dorsheed455k/MSI-Capstone/Images/Screenshot 2026-03-16 171824.jpg

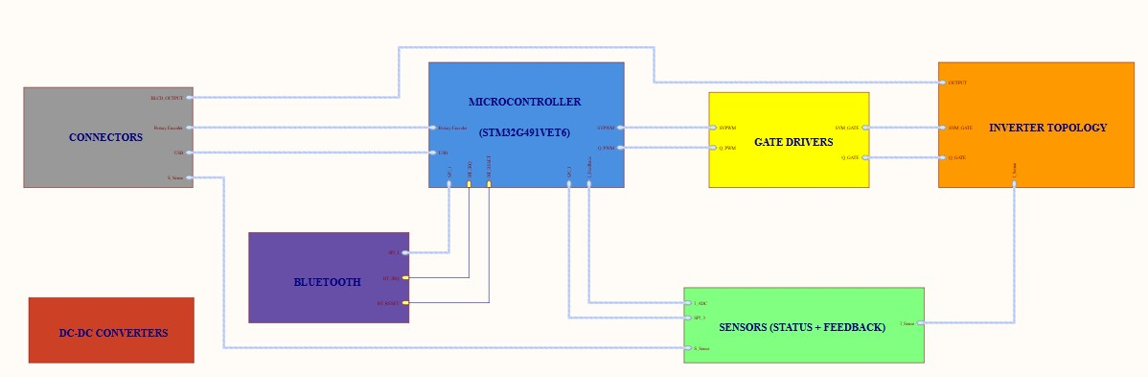
Images/Screenshot 2026-03-16 171824.jpg
