dorsheed455k/MSI-Capstone/Images/Screenshot 2026-03-30 085603.jpg

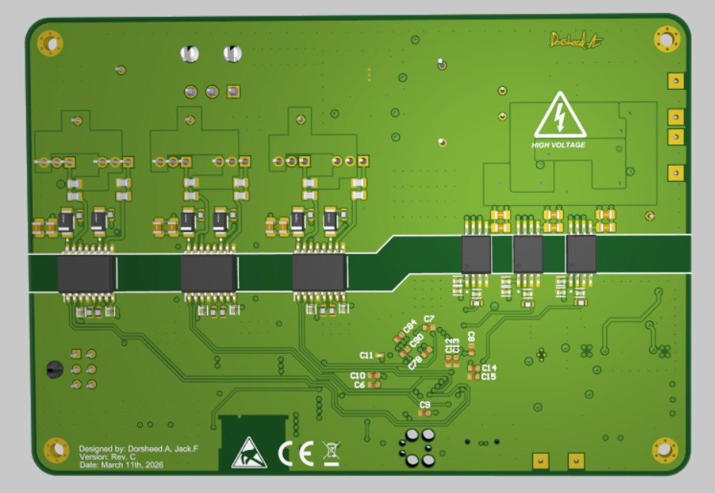
Images/Screenshot 2026-03-30 085603.jpg
