dorsheed455k/MSI-Capstone/Images/Screenshot 2026-04-18 185659.jpg

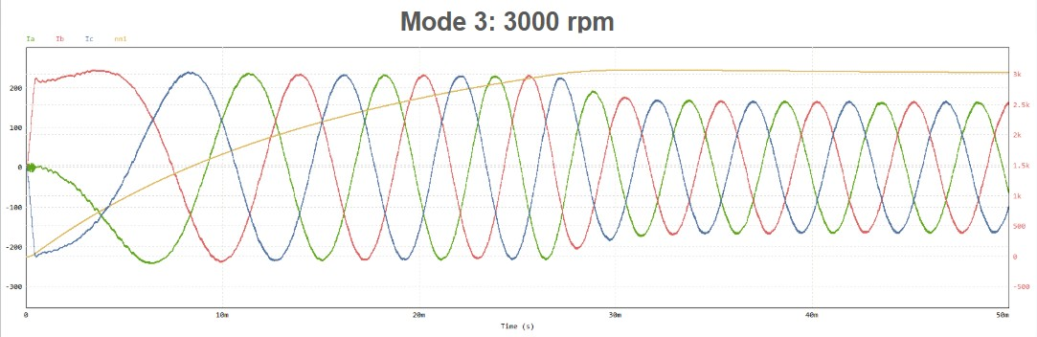
Images/Screenshot 2026-04-18 185659.jpg
