dorsheed455k/MSI-Capstone/Hardware/Schematic PDF_[No Variations] (1).pdf

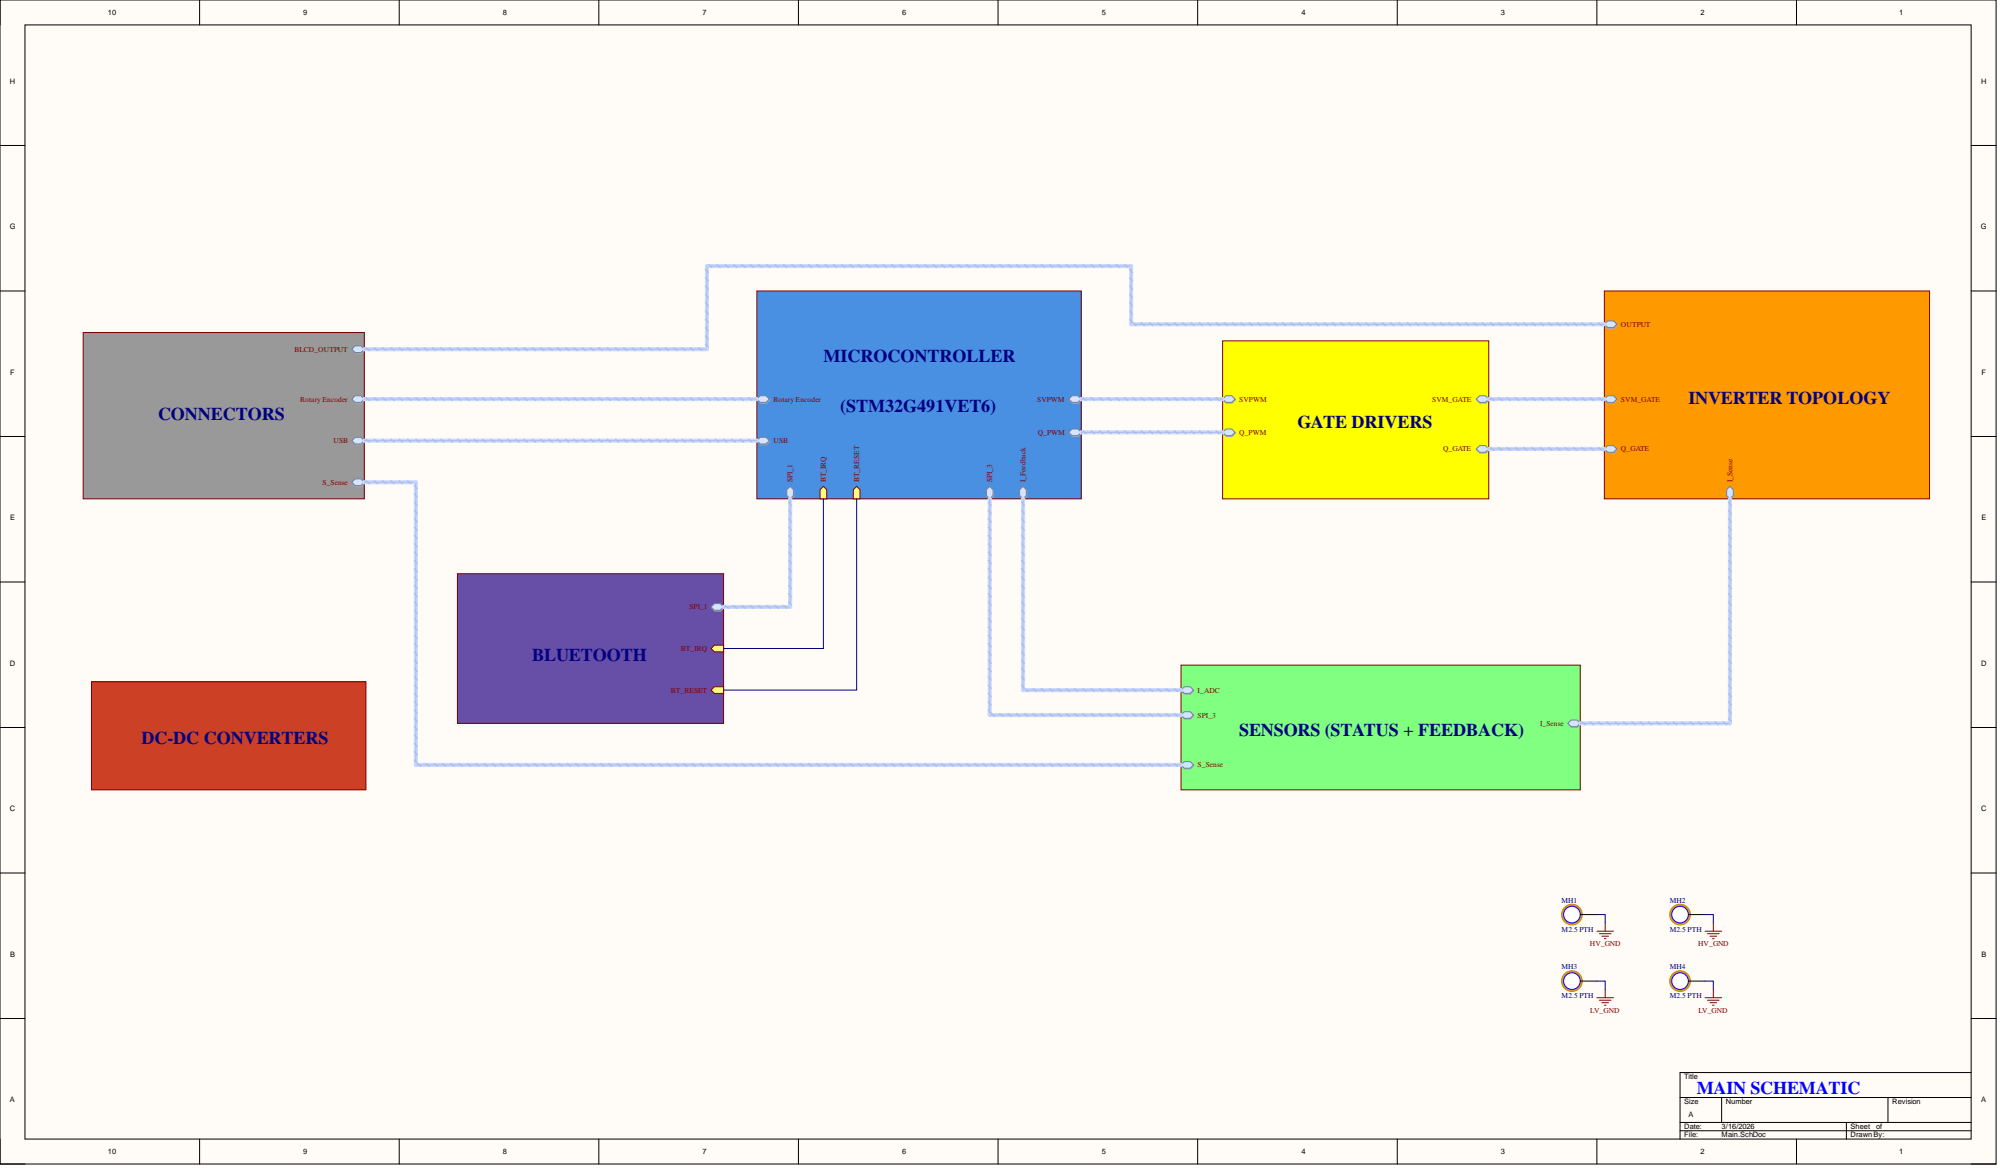
[picture p11: page 1]
Date:; Sheet of; File:; Main.SchDoc; Drawn By:; Rotary Encoder; INVERTER TOPOLOGY; MAIN SCHEMATIC; M2.5 PTH; GATE DRIVERS

SPI_3
SENSORS (STATUS + FEEDBACK)

DC-DC CONVERTERS

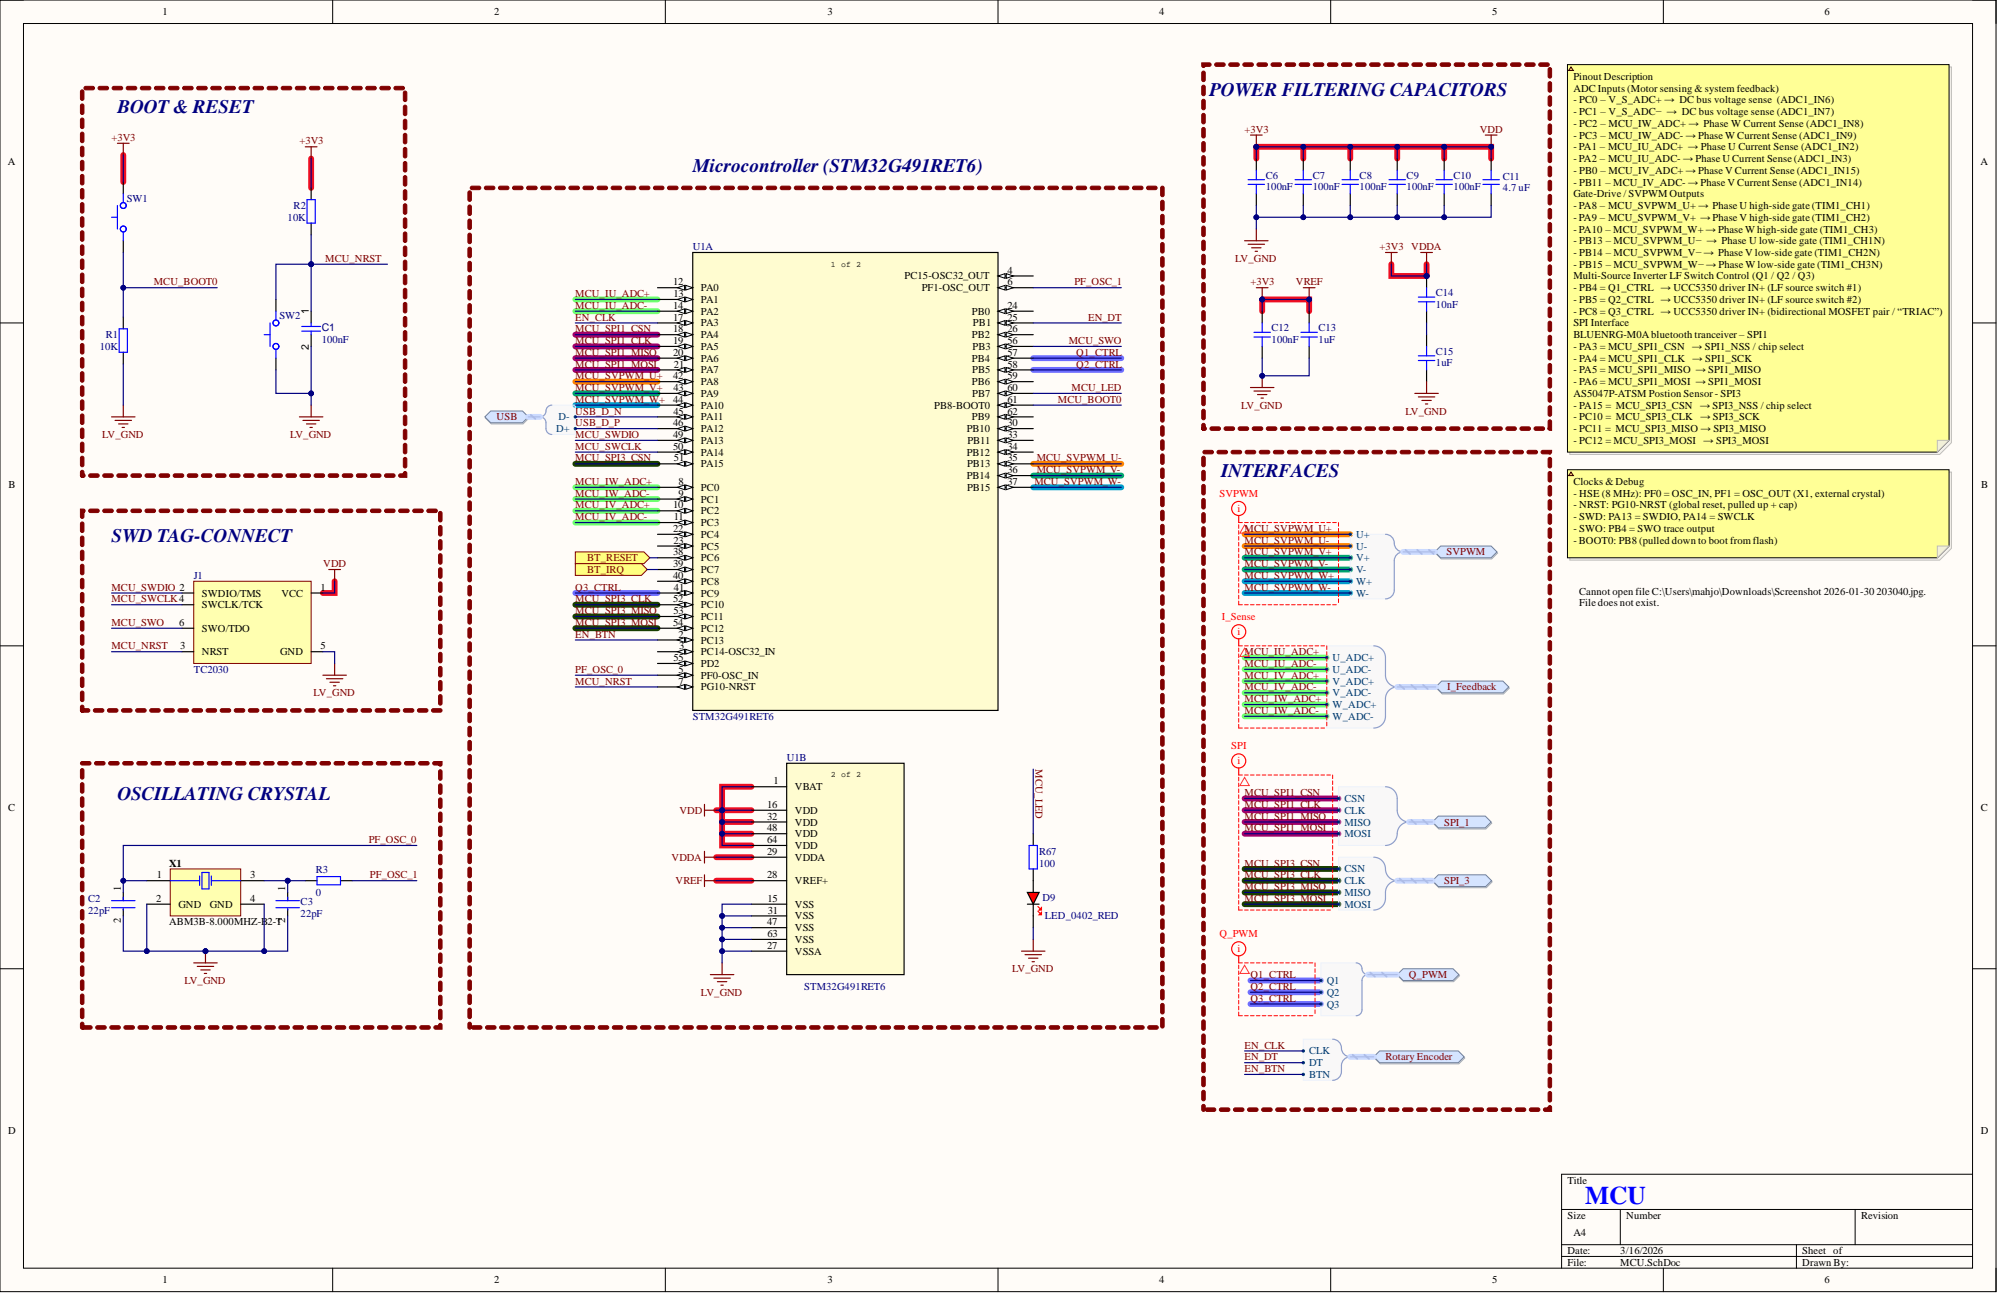
[picture p12: page 2]

1 6
3 2
4 8
6 4

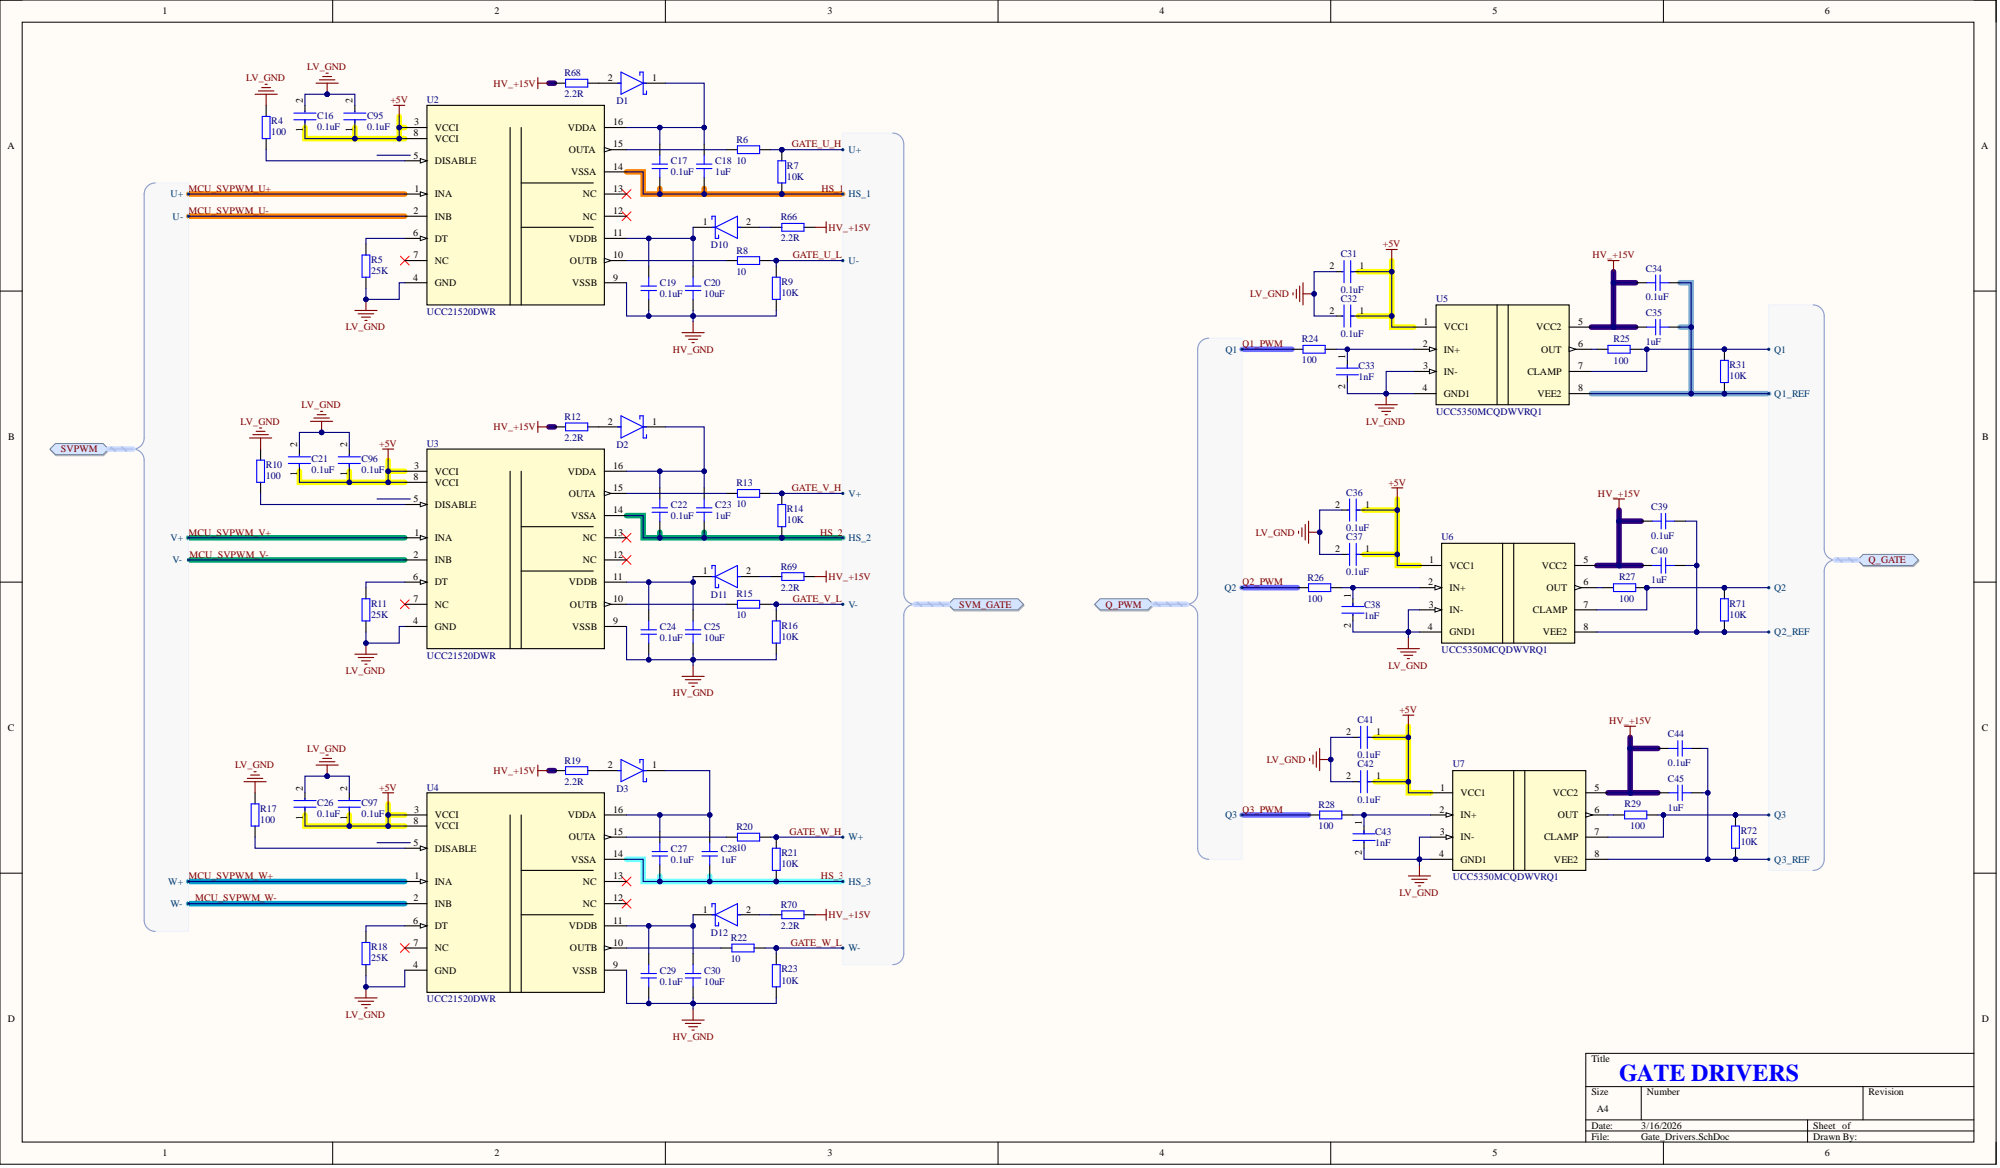
[picture p13: page 3]

C3 8 3 | | 7
1 n F | 4 | | 8

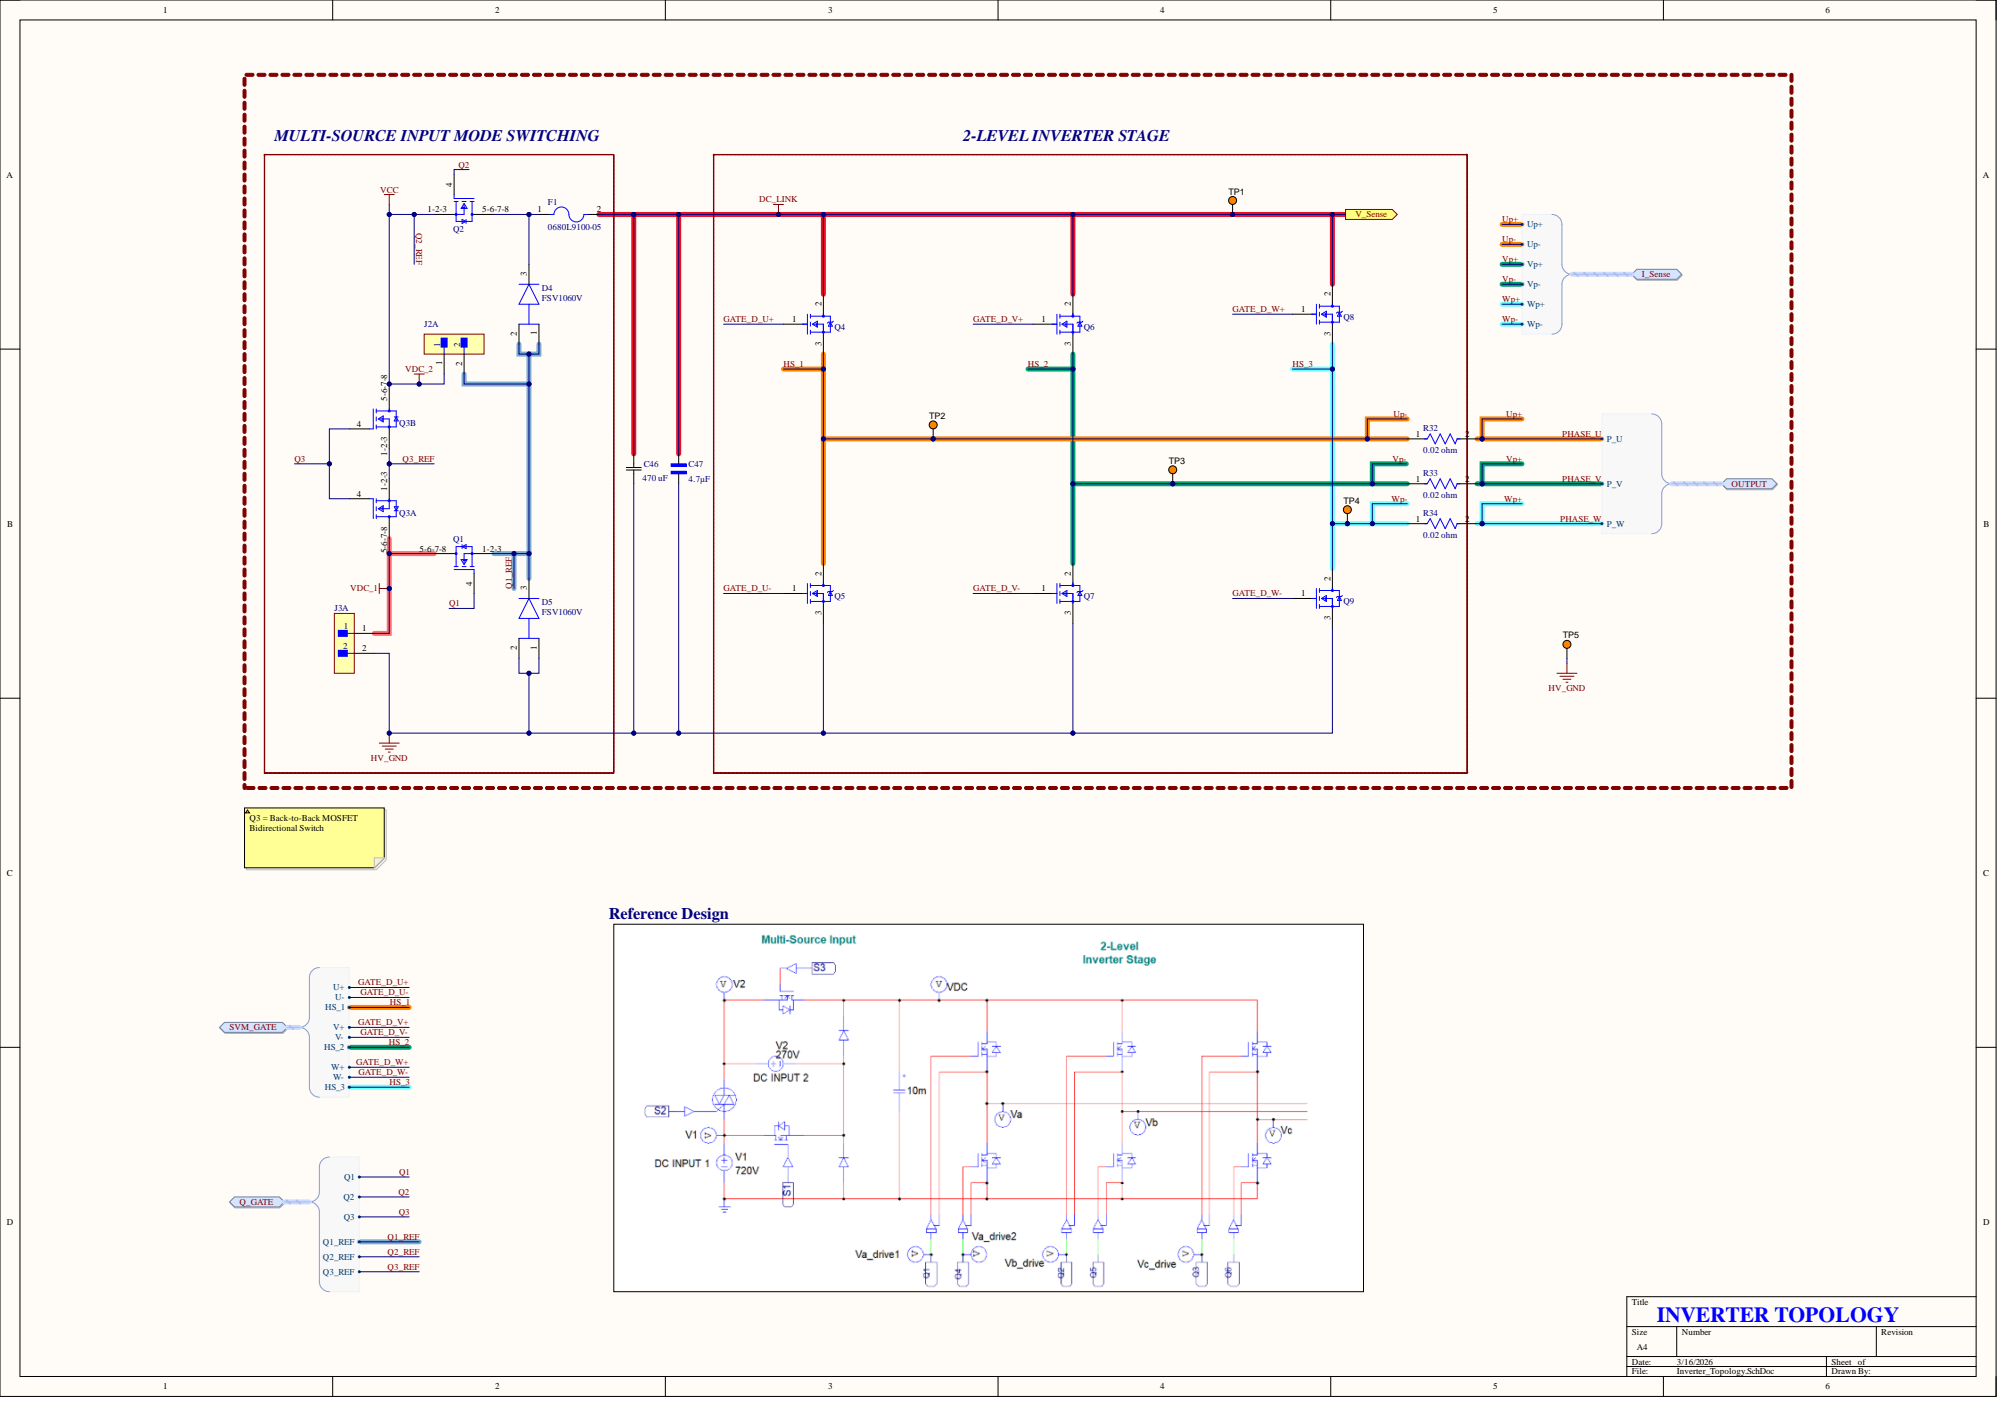
[picture p14: page 4]

MULTI-SOURCE INPUT MODE SWITCHING

Q3 = Back-to-Back MOSFET
Bidirectional Switch

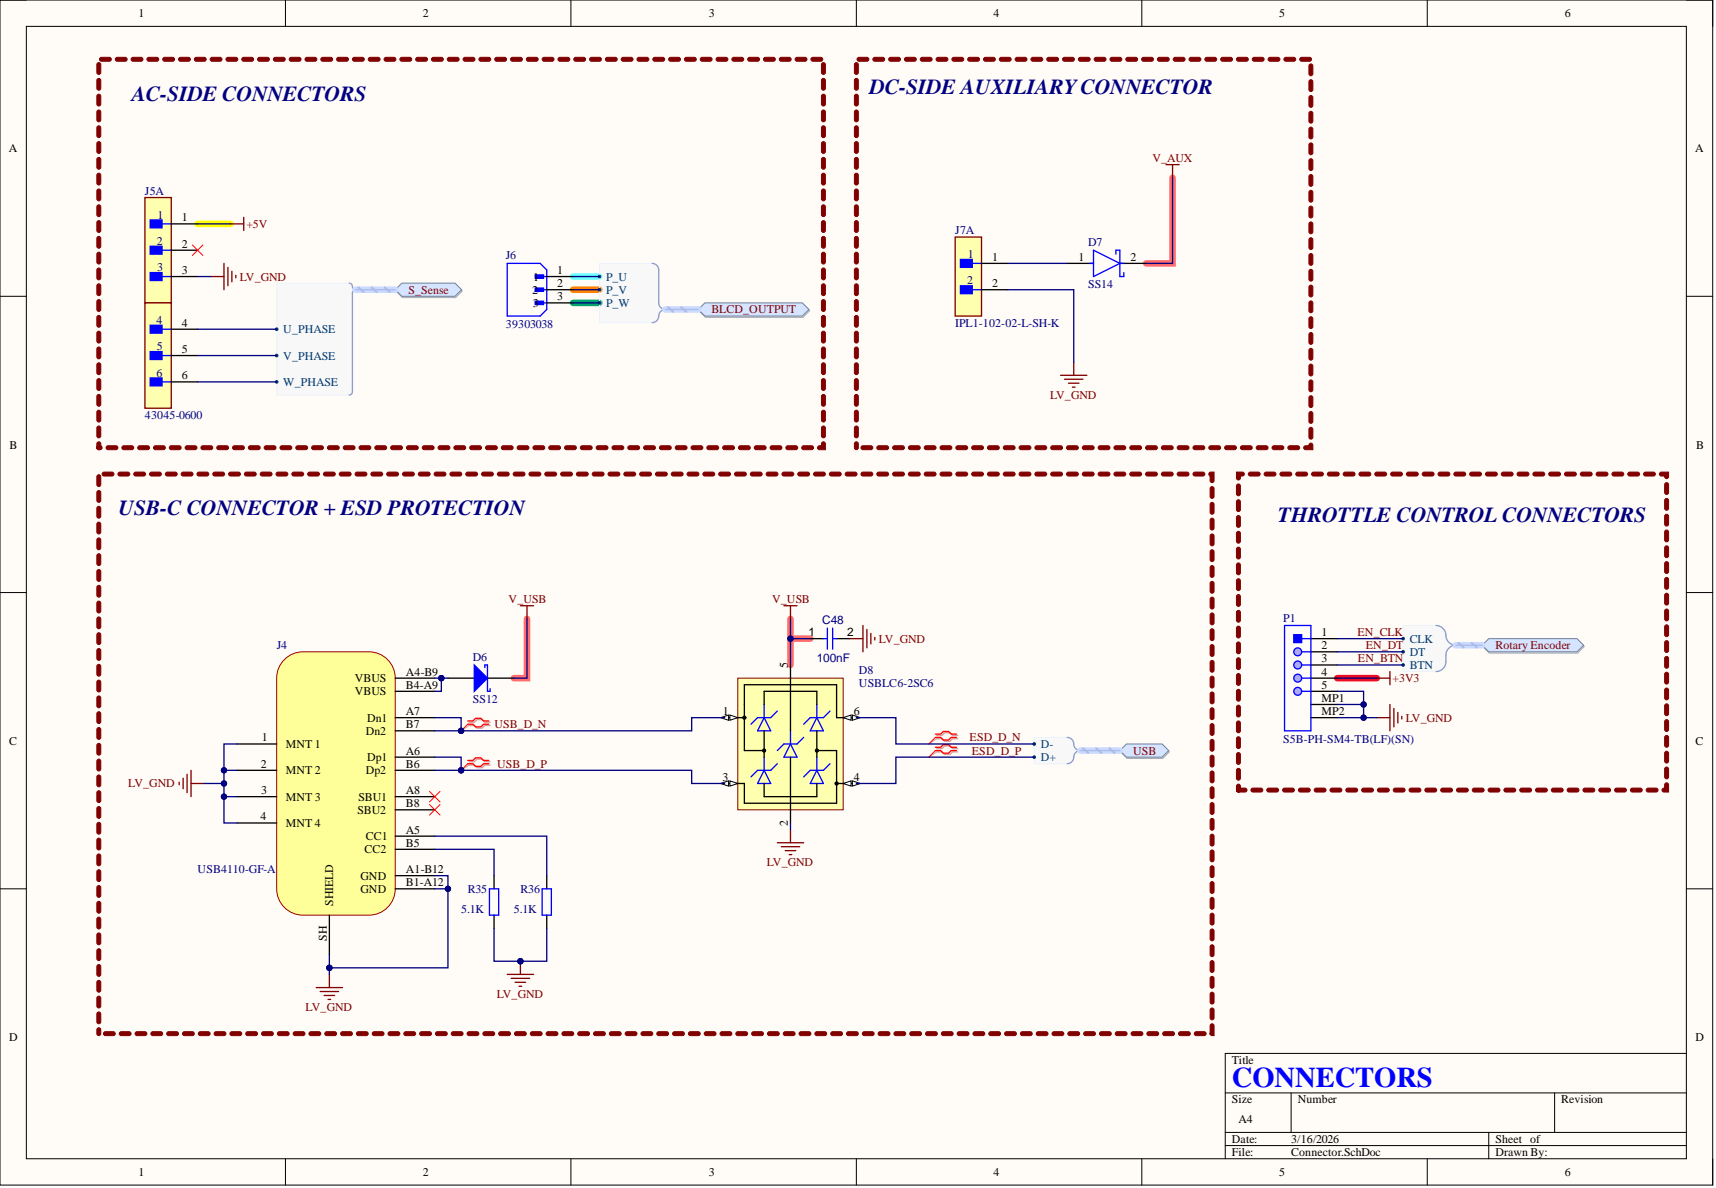
[picture p15: page 5]

USB-C CONNECTOR + ESD PROTECTION

ESD_D_N

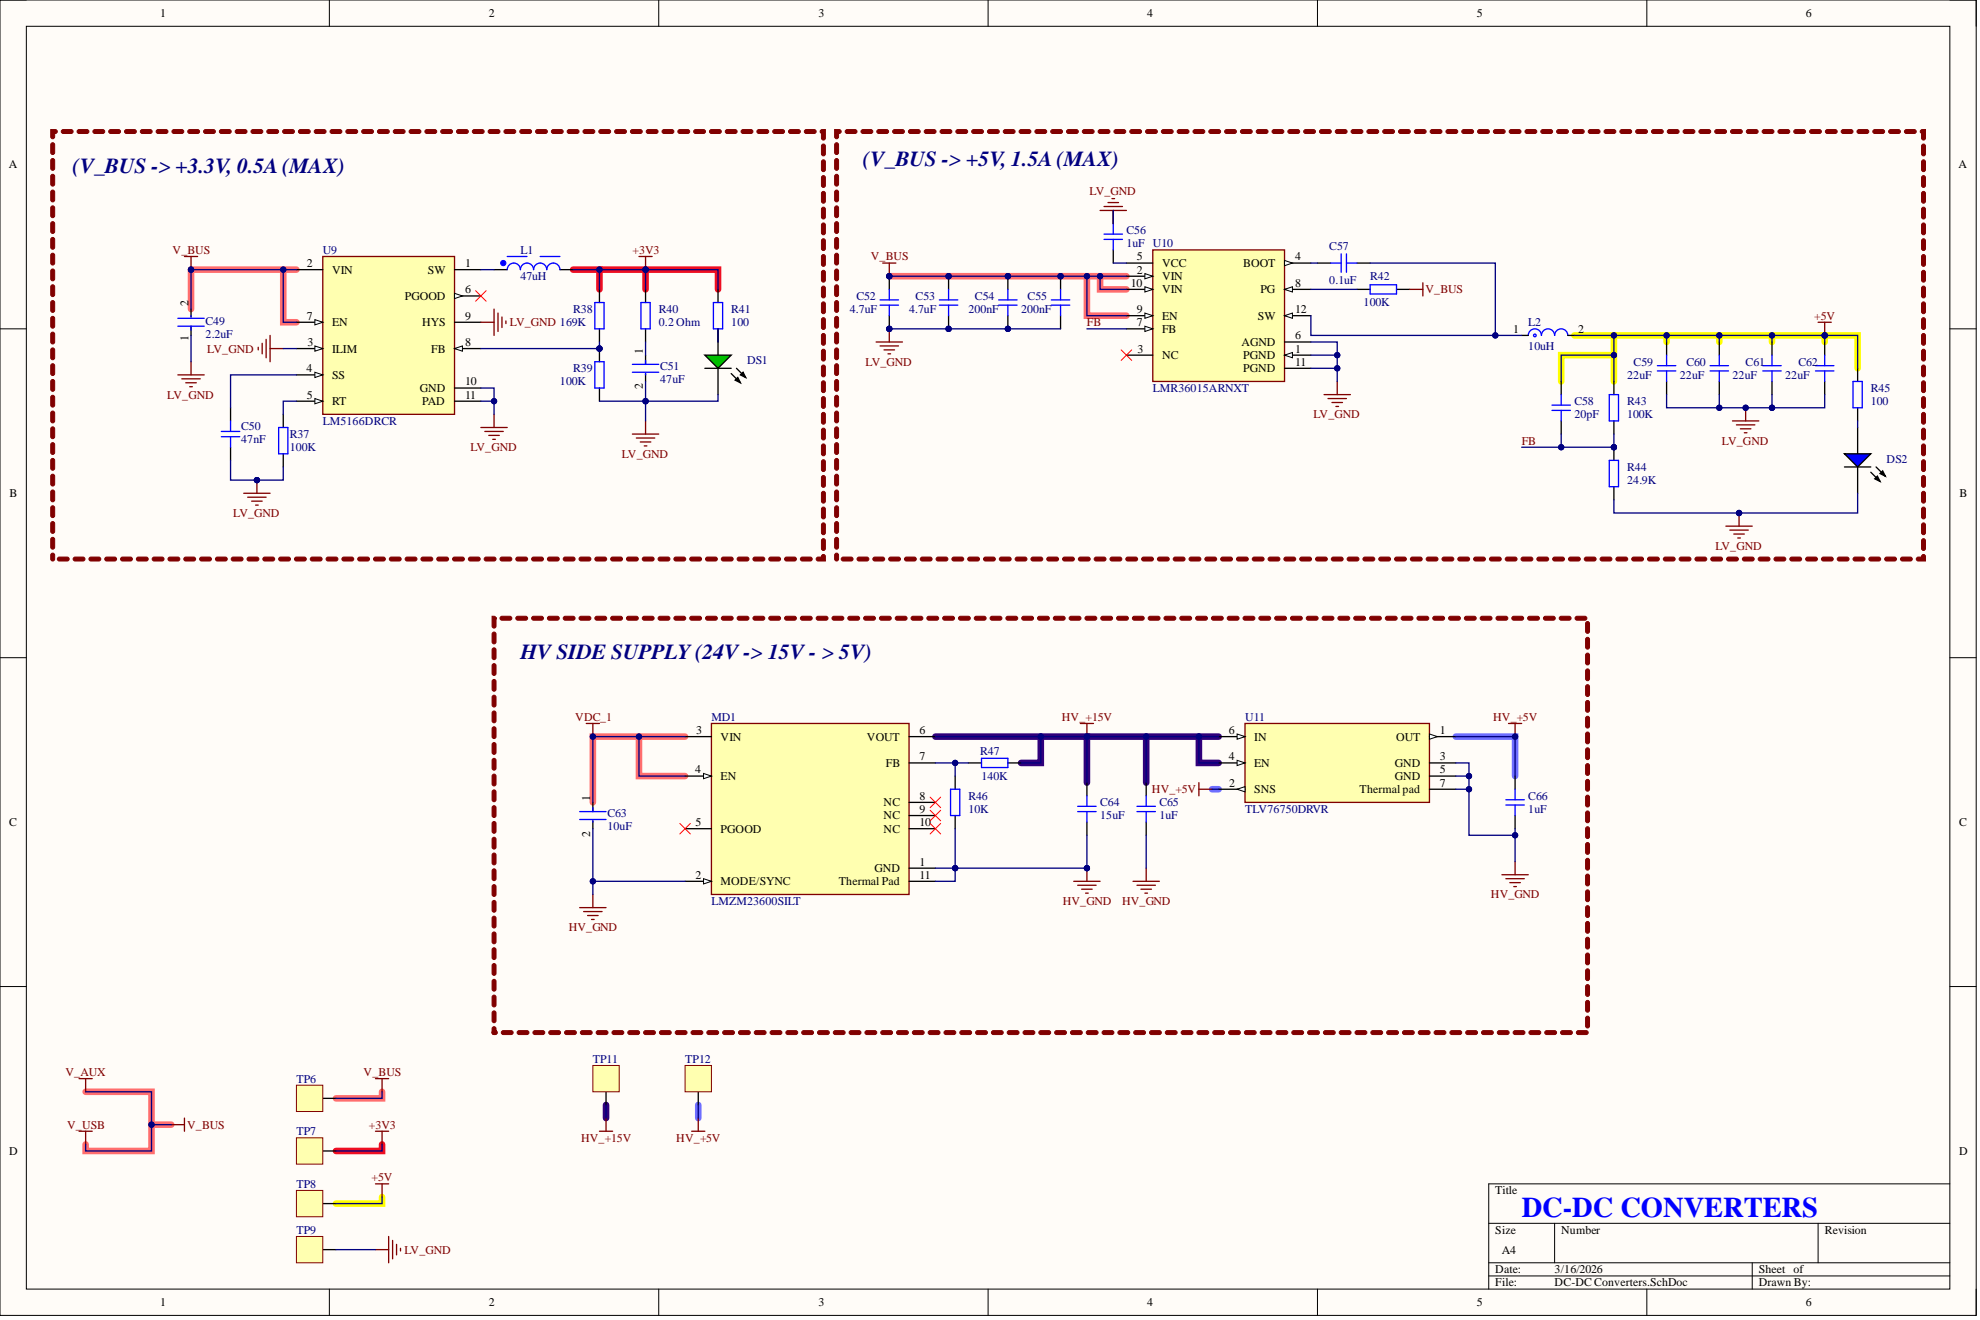
[picture p16: page 6]

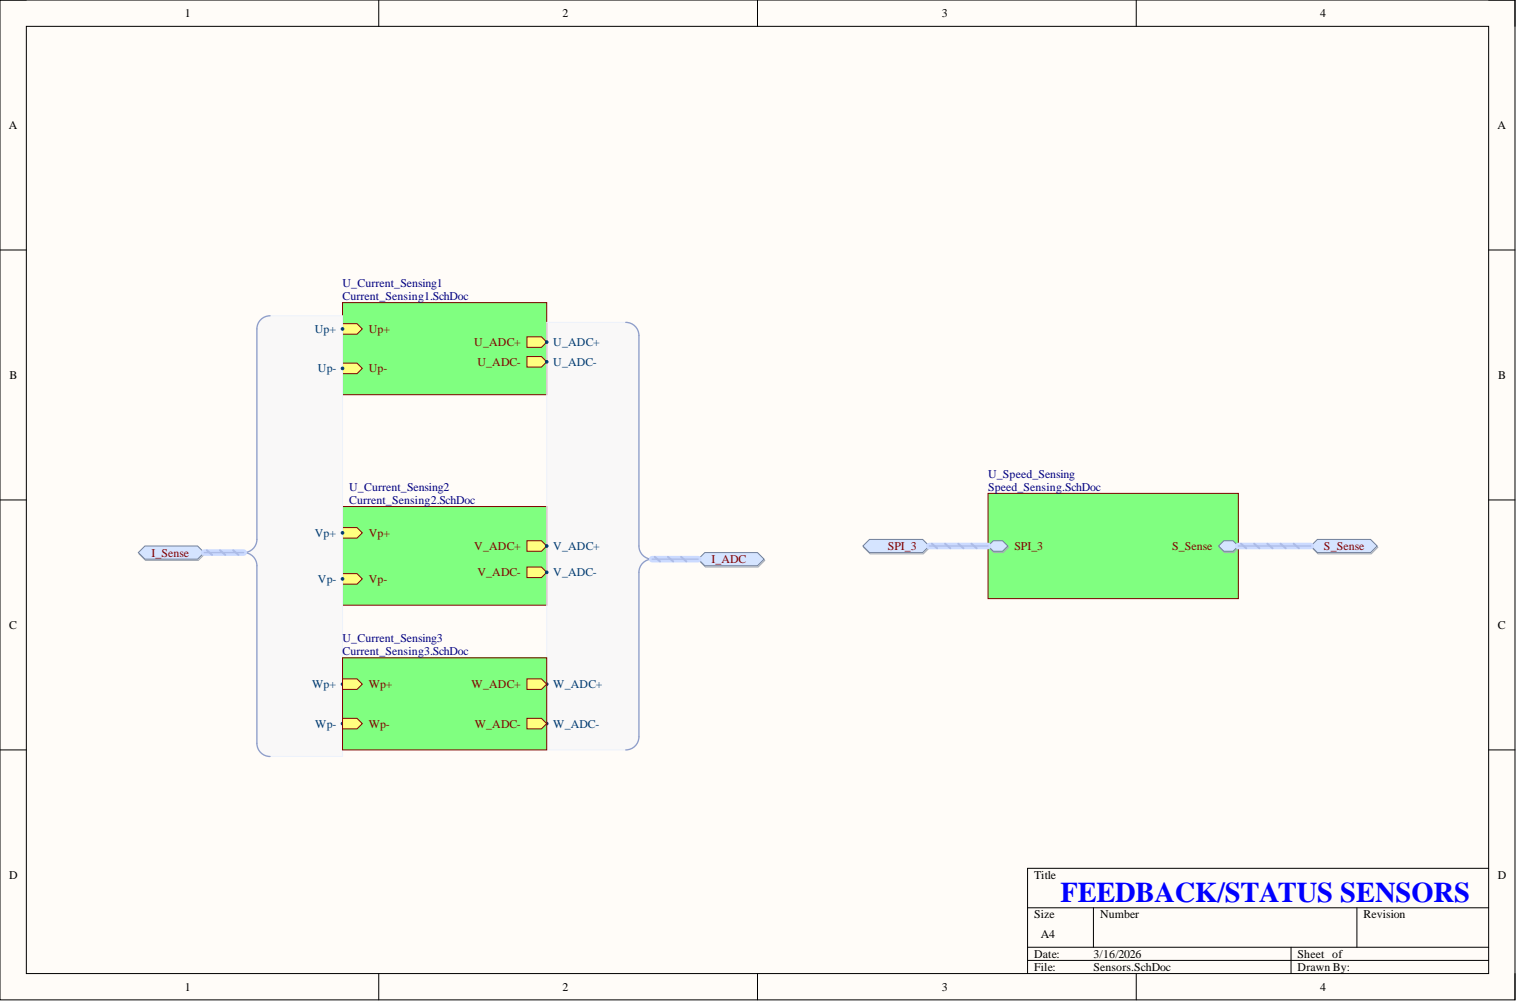
[picture p17: page 7]
ATUS SENSORS; POSPI03; POS0Sense POI0ADC POI0Sense; POI0ADC0U0ADC0 POI0ADC0V0ADC0 POI0ADC0W0ADC0 POI0Sense0Up0 POI0Sense0Vp0 POI0Sense0Wp0; POSPI03 POSPI030CLK POSPI030CSN POSPI030MISO POSPI030MOSI; POS0Sense POS0Sense0U0PHASE POS0Sense0V0PHASE POS0Sense0W0PHASE

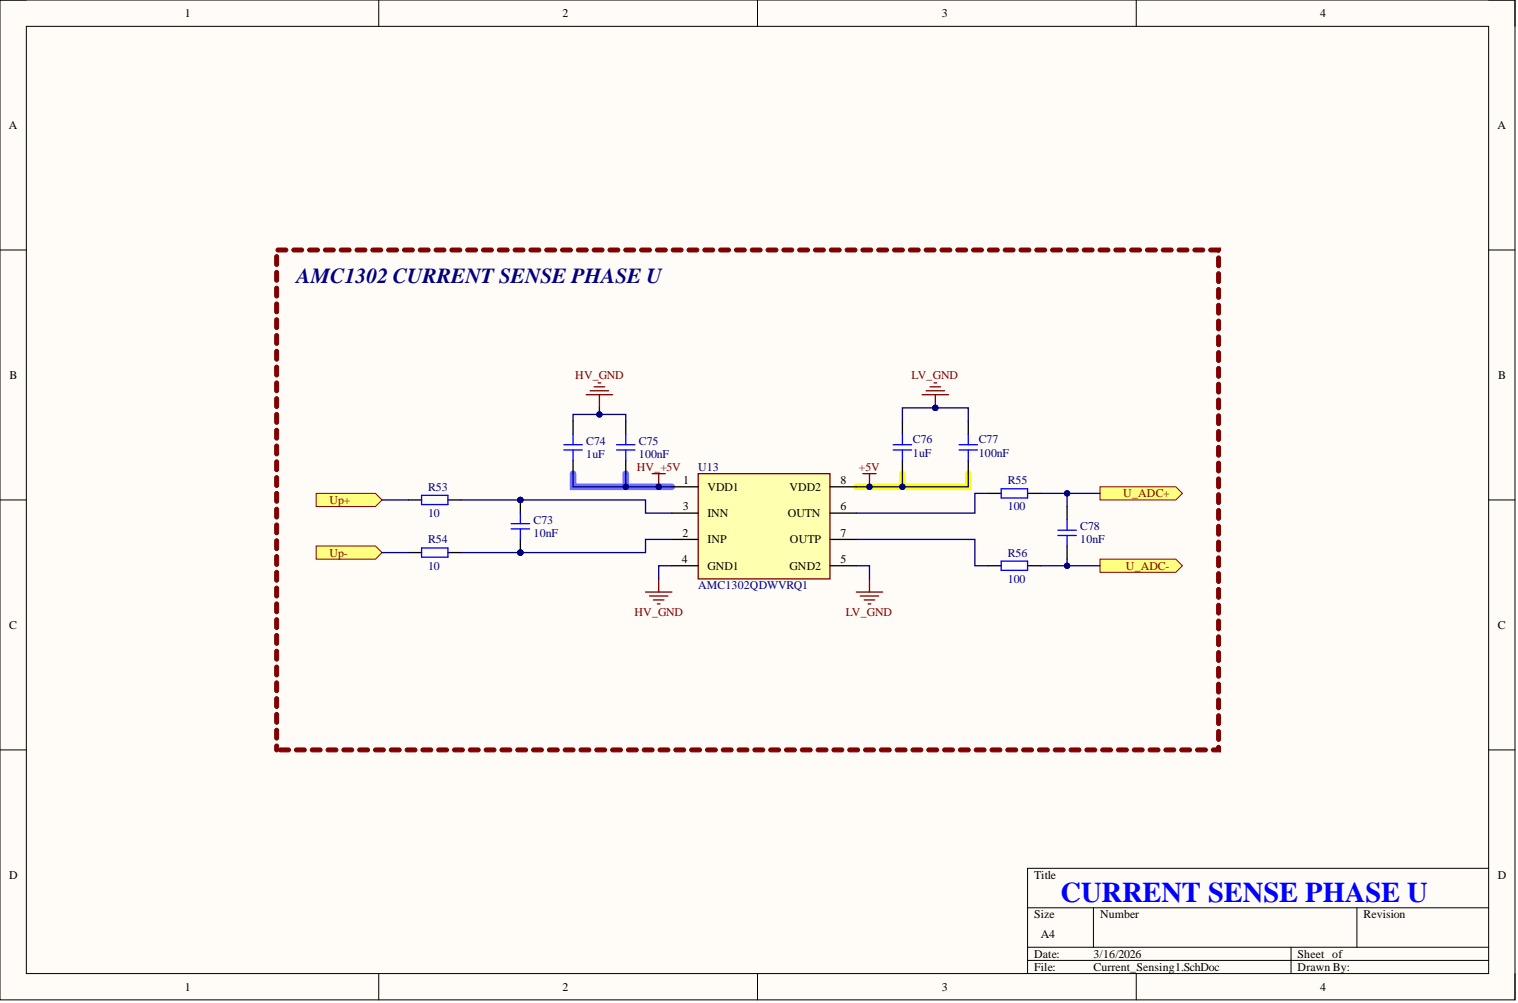
[picture p18: page 8]

2 CURRENT SENSE PHASE

CURRENT SENSE PHASE U

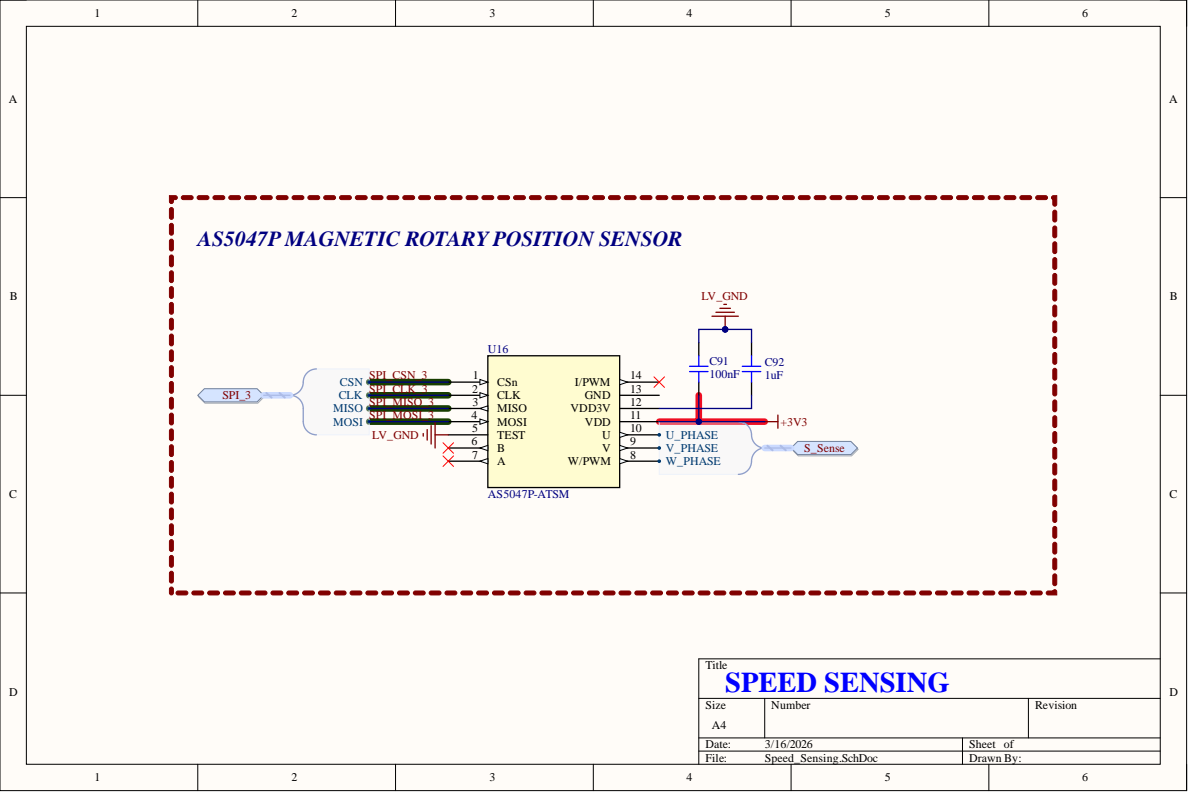
[picture p19: page 9]
SPEED SENSING; 7P MAGNETIC ROTAR; Y POSITION SENSOR; 3 I/PWM

1 2
1 1

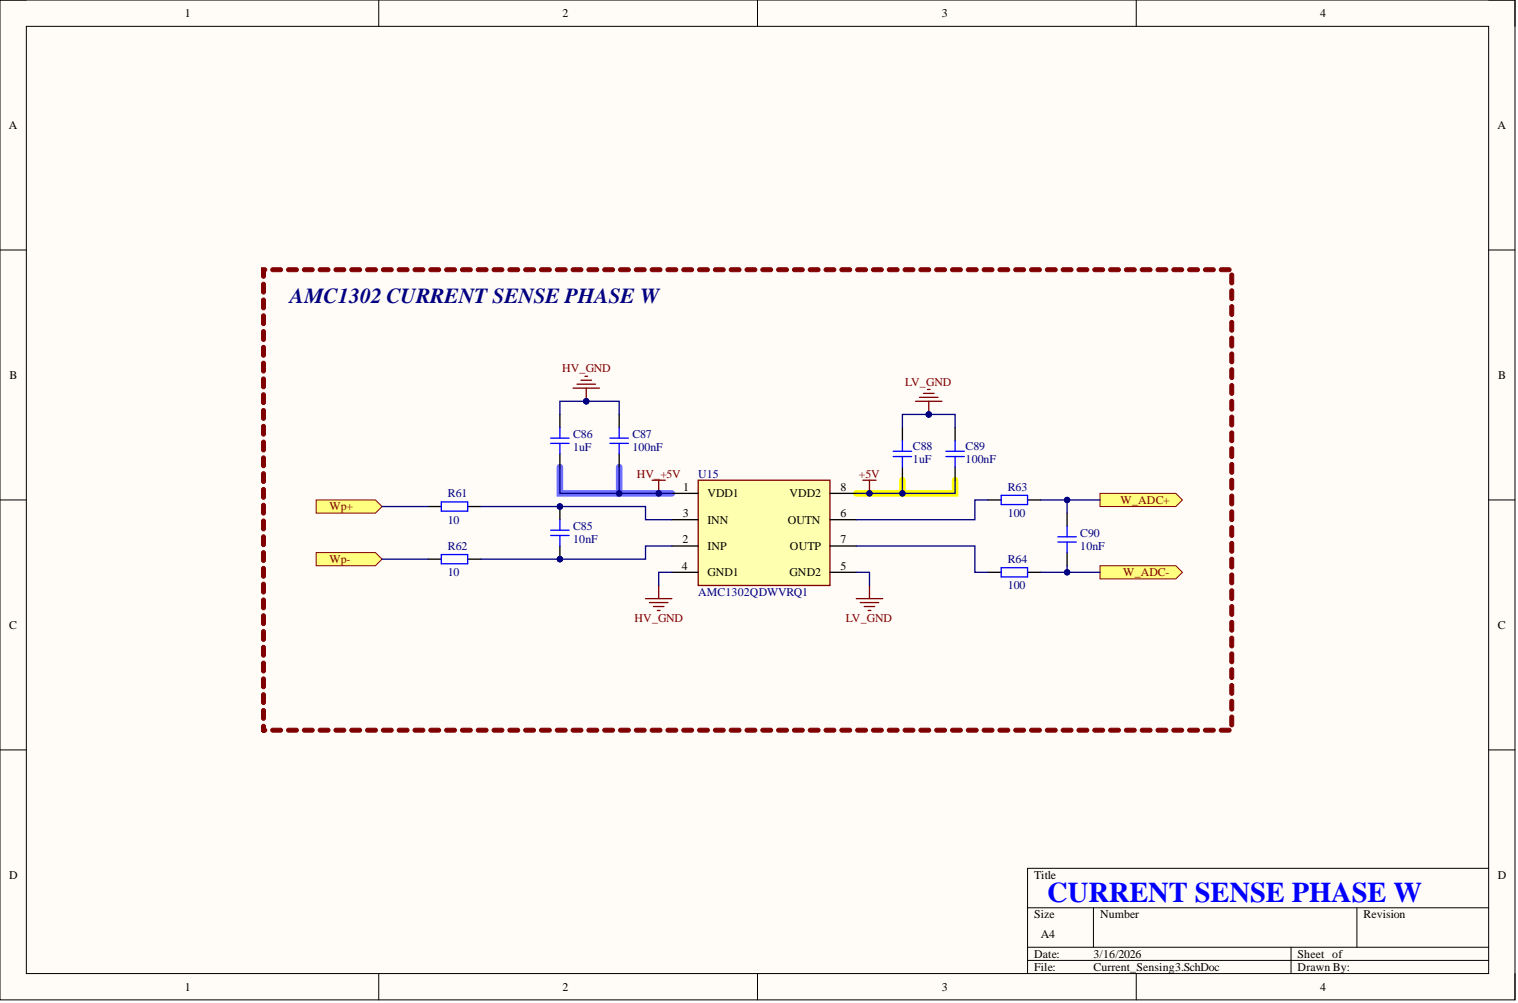
[picture p20: page 10]

2 CURRENT SENSE PHASE

CURRENT SENSE PHASE

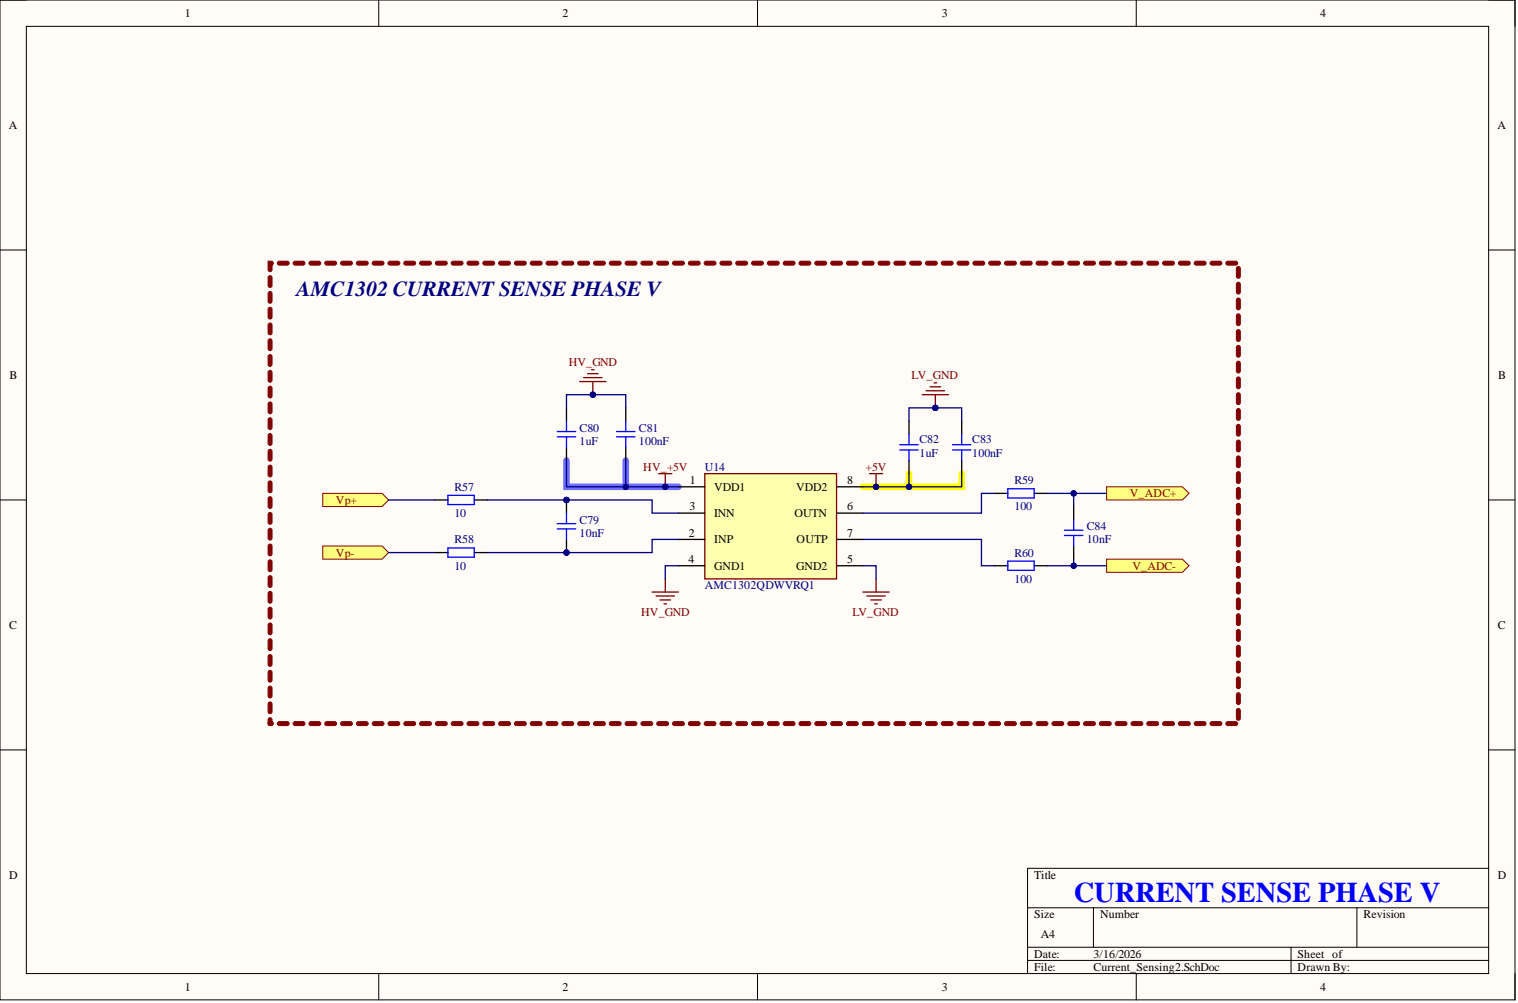
[picture p21: page 11]

2 CURRENT SENSE PHASE

CURRENT SENSE PHASE

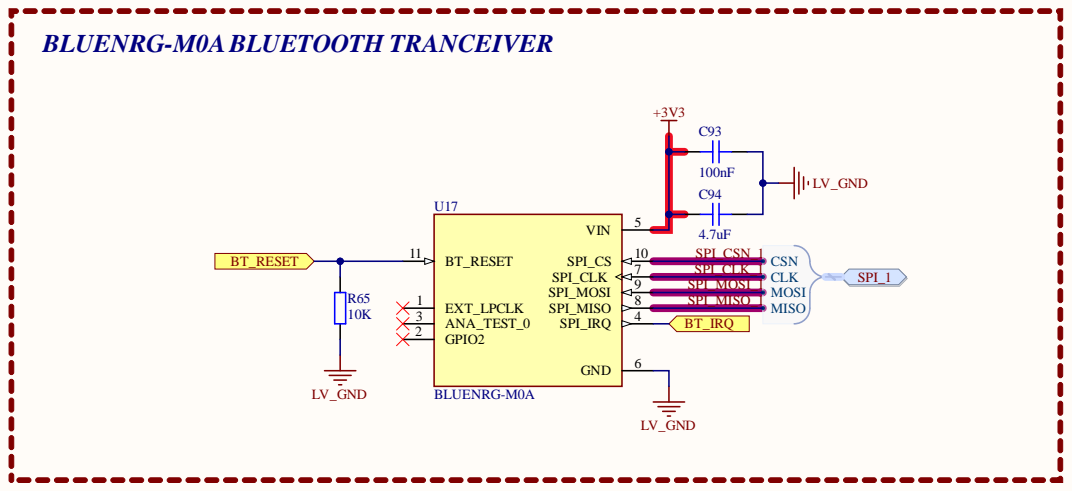
[picture p22: page 12]
File:; Bluetooth.SchDoc; Drawn By:; BT_RESET 11; EXT_LPCLK 1 ANA_TEST_0 3 GPIO2 2; SPI_CLK_1; SPI_1 SPI_MOSI_1; BLUENRG-M0ABLUETOOTH TRANCEIVER
