dorsheed455k/MSI-Capstone/Hardware/Assembly Drawings_[No Variations].pdf

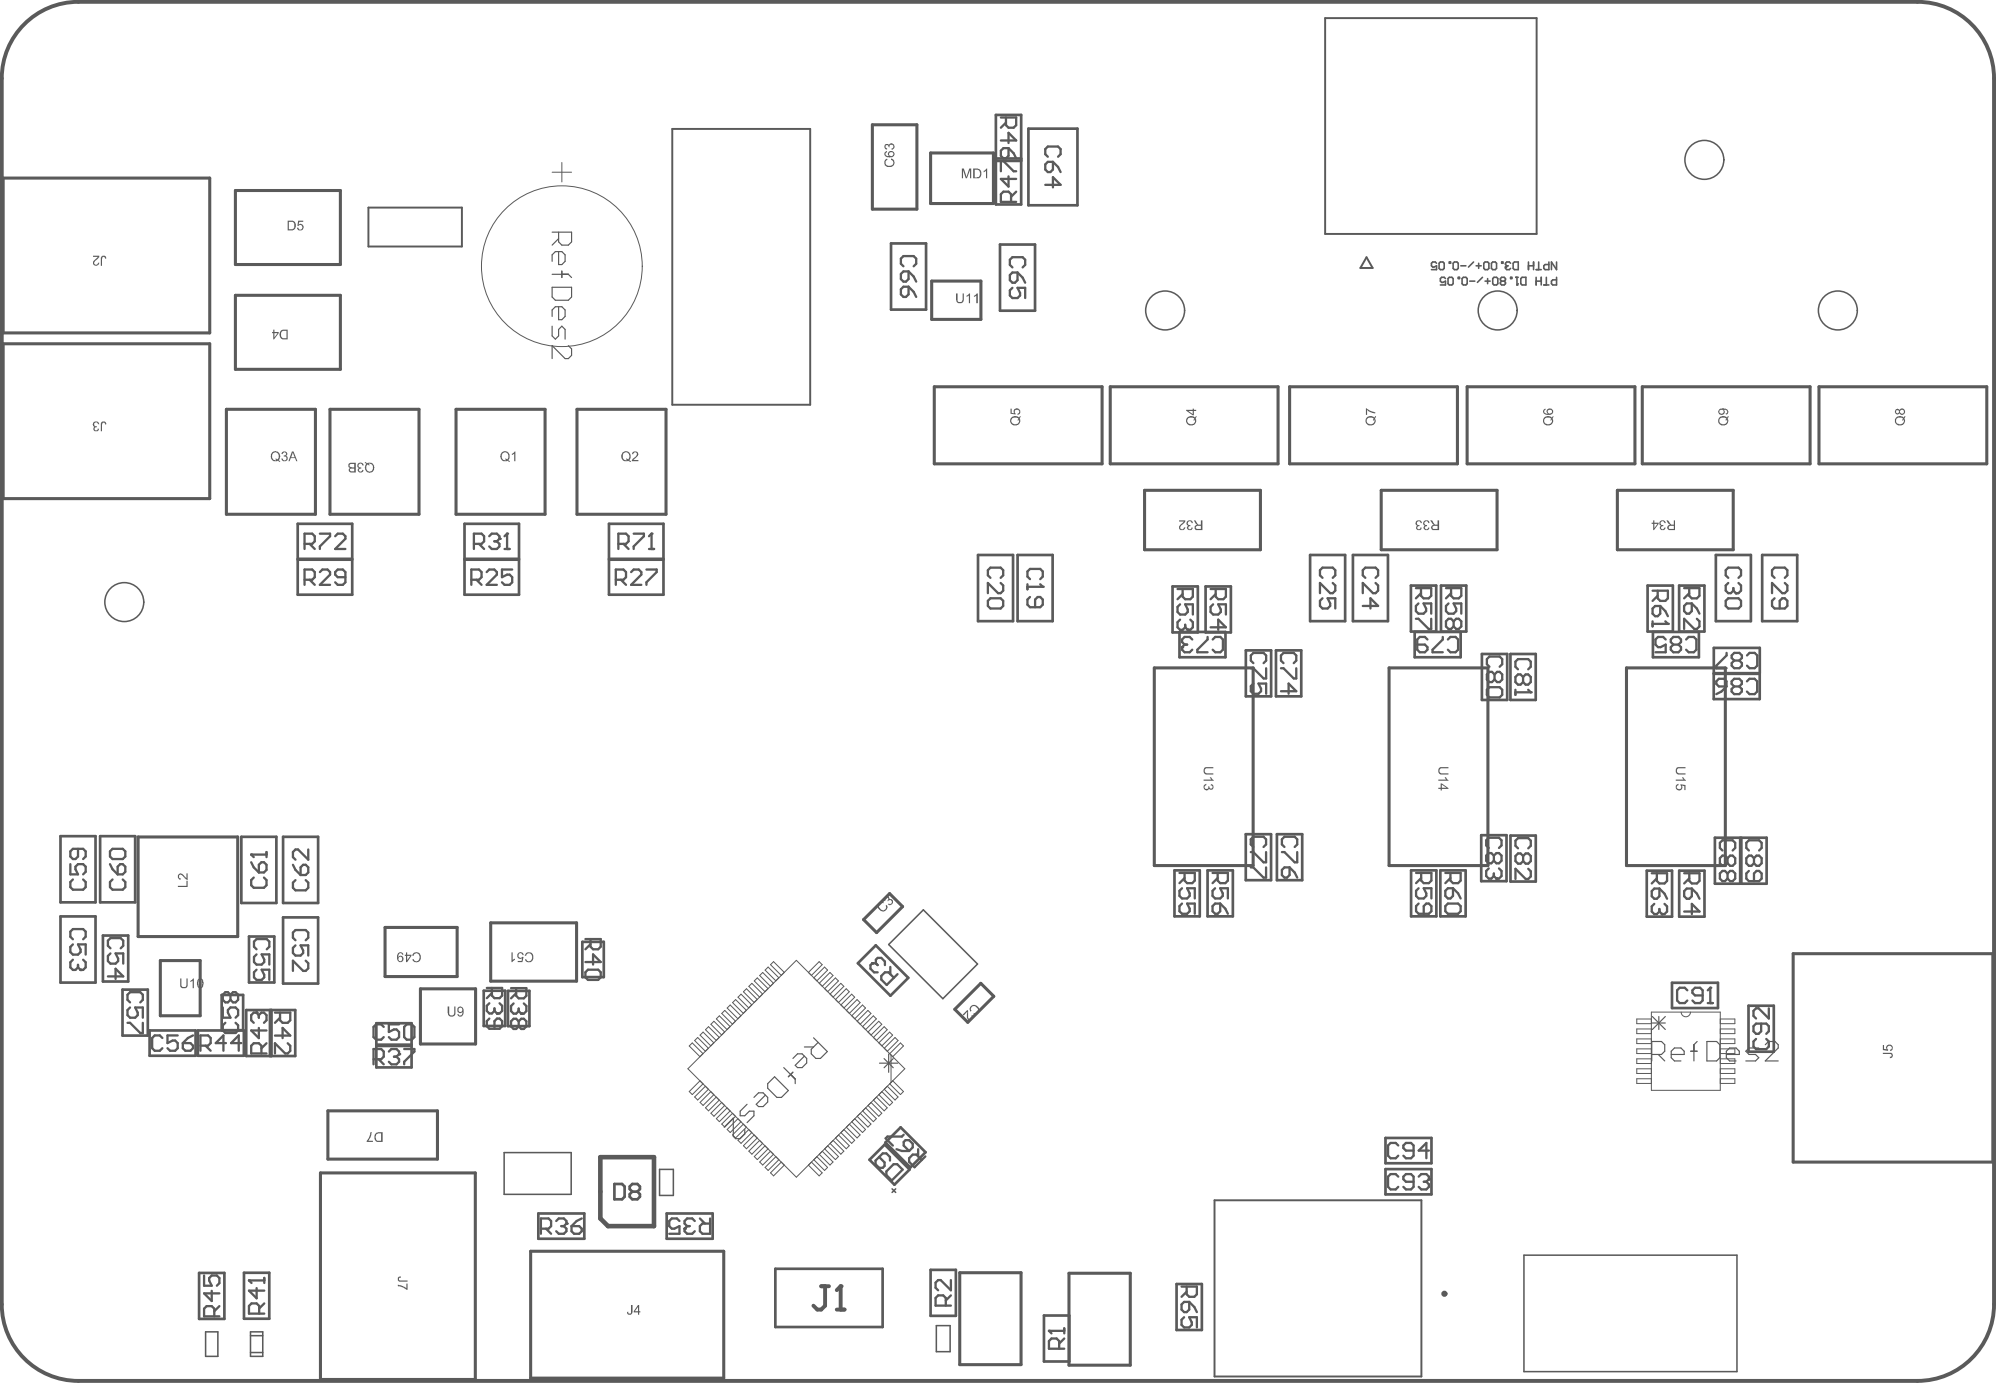
[picture p34: page 1]

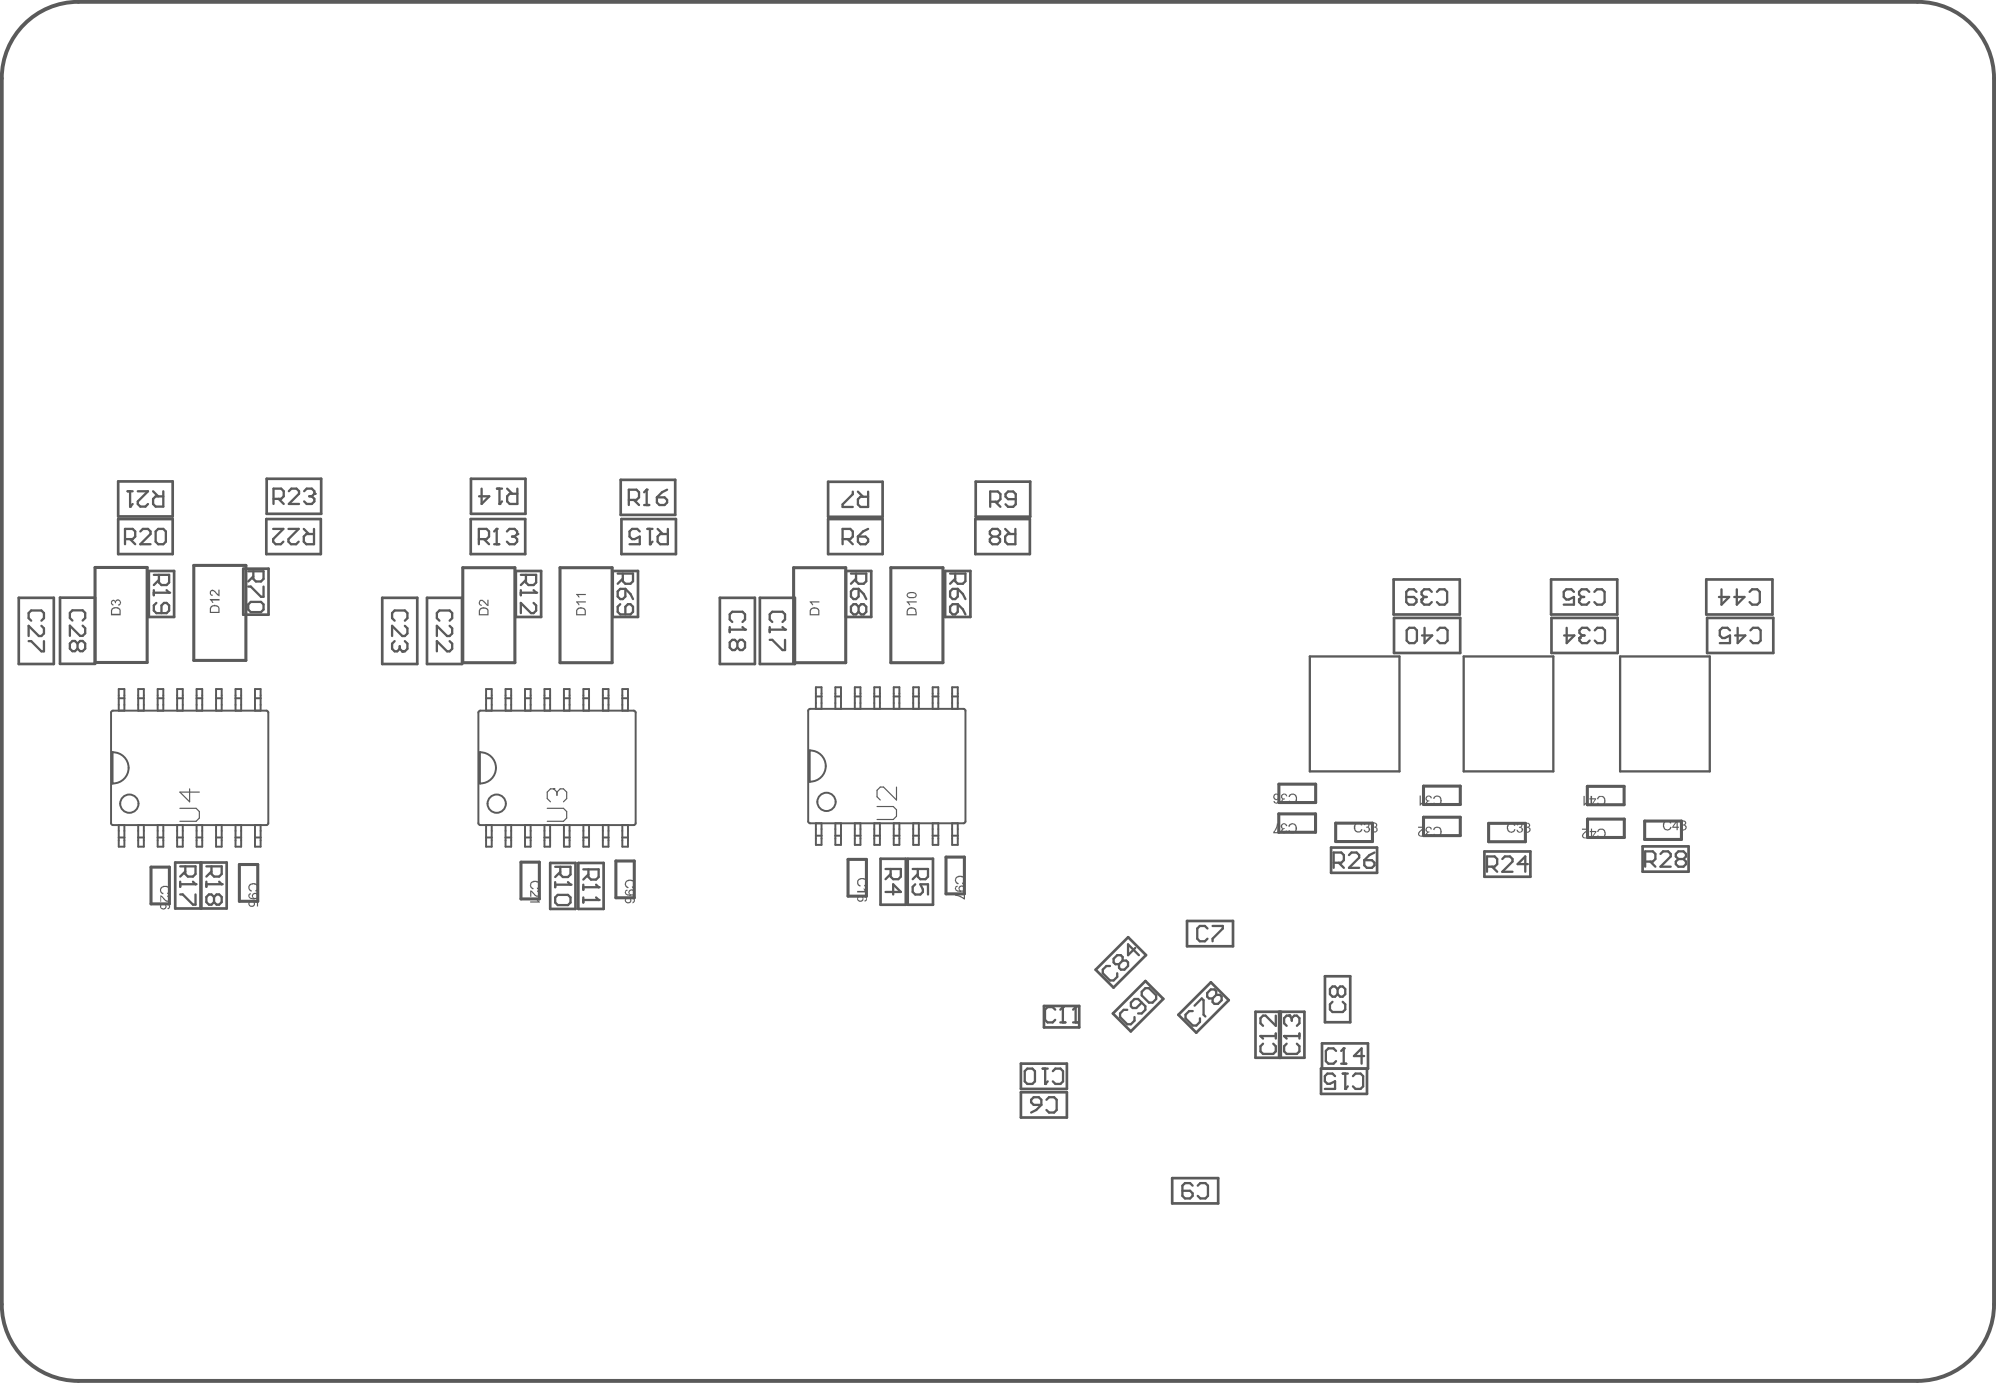
[picture p35: page 2]
