dorsheed455k/MSI-Capstone/(commit log)

2026-03-16 Test 2
    [tmp_pi_params.txt]
2026-03-18 Fix CurrentSense_t and integrate Web Interface
    [amc1302.h, main.c]
2026-03-20 Refactor ms_switch module and fix build errors
    [amc1302.c, amc1302.h, main.c, ms_switch.c, ms_switch.h]
2026-03-25 Antigravity: Apply integrated Bluetooth SPI1 and USB fixes
    [main.c]
